Melvin-Larsson/keyboard/keyboard/keyboard.csv

Reference | Qty | Value | DNP | Exclude from BOM | Exclude from Board | Footprint | Datasheet
3.3V1,BAT+1,BAT-1,CAPS2,CHG1,CHOUT1,DIS1,FUELOUT1,GND1,NUM2,RCLK1,REG1,SCROLL2,SER1,SRCLK1,STAT1,STAT2,USB_on1,VBUS1 | 19 | TestPoint |  |  |  | TestPoint:TestPoint_THTPad_D2.0mm_Drill1.0mm
AE1 | 1 | Antenna_Chip |  |  |  | footprints:PCB-Antenna
BT1 | 1 | Battery_Cell |  |  |  | footprints:solder_pads
C1,C15,C18,C19,C20 | 5 | 0.1μF |  |  |  | Capacitor_SMD:C_0603_1608Metric
C2,C3 | 2 | 12pF |  |  |  | Capacitor_SMD:C_0201_0603Metric
C4 | 1 | 0.1uF |  |  |  | Capacitor_SMD:C_0603_1608Metric
C5 | 1 | N.C |  |  |  | Capacitor_SMD:C_0603_1608Metric
C7,C27,C28 | 3 | 4.7μF |  |  |  | Capacitor_SMD:C_0201_0603Metric
C11,C12 | 2 | 10μf |  |  |  | Capacitor_SMD:C_0603_1608Metric
C13 | 1 | 1μf |  |  |  | Capacitor_SMD:C_0603_1608Metric
C14,C16,C17 | 3 | 10μF |  |  |  | Capacitor_SMD:C_0603_1608Metric
C21 | 1 | 0.47μF |  |  |  | Capacitor_SMD:C_0603_1608Metric
C25,C29 | 2 | 1.0μF |  |  |  | Capacitor_SMD:C_0201_0603Metric
C26 | 1 | 4.7uF |  |  |  | Capacitor_SMD:C_0201_0603Metric
C30,C35 | 2 | 100nF |  |  |  | Capacitor_SMD:C_0201_0603Metric
C31 | 1 | 100pF |  |  |  | Capacitor_SMD:C_0201_0603Metric
C32 | 1 | N.C. |  |  |  | Capacitor_SMD:C_0201_0603Metric
C33 | 1 | 1.0pF |  |  |  | Capacitor_SMD:C_0201_0603Metric
C34 | 1 | 1.2pF |  |  |  | Capacitor_SMD:C_0201_0603Metric
CAPS1,D82,D83,D84,NUM1,Scroll1 | 6 | LED |  |  |  | LED_SMD:LED_0603_1608Metric
D1,D2,D3,D4,D5,D6,D7,D8,D9,D10,D11,D12,D13,D14,D15,D16,D17,D18,D19,D20,D21,D22,D23,D24,D25,D26,D27,D28,D29,D30,D31,D32,D33,D34,D35,D36,D37,D38,D39,D40,D41,D42,D44,D45,D46,D47,D48,D49,D50,D51,D52,D53,D54,D55,D56,D57,D58,D59,D60,D61,D62,D63,D64,D65,D66,D67,D68,D69,D70 | 69 | D_Small |  |  |  | Diode_SMD:D_SOD-323
D85 | 1 | D_TVS |  |  |  | Diode_SMD:Nexperia_DSN1608-2_1.6x0.8mm
J1 | 1 | Conn_01x06_Pin |  |  |  | Connector_PinHeader_2.54mm:PinHeader_2x03_P2.54mm_Vertical
L1 | 1 | 4.7nH |  |  |  | Inductor_SMD:L_0201_0603Metric
L2 | 1 | 2.2μH |  |  |  | Inductor_SMD:L_6.3x6.3_H3
L3 | 1 | 2.2nH |  |  |  | Inductor_SMD:L_0201_0603Metric
P1 | 1 | USB_C_Plug_USB2.0 |  |  |  | Connector_USB:USB_C_Receptacle_G-Switch_GT-USB-7010ASV | https://www.usb.org/sites/default/files/documents/usb_type-c.zip
Q1,Q2,Q3,Q4,Q5 | 5 | Q_NMOS_GSD |  |  |  | Package_TO_SOT_SMD:SOT-23
R1,R2,R3,R13 | 4 | 100kΩ |  |  |  | Resistor_SMD:R_0603_1608Metric
R4,R5 | 2 | 5.1kΩ |  |  |  | Resistor_SMD:R_0603_1608Metric
R10,R11,R12 | 3 | 330Ω |  |  |  | Resistor_SMD:R_0603_1608Metric
R14 | 1 | 37.4kΩ |  |  |  | Resistor_SMD:R_0603_1608Metric
R15,R17,R19 | 3 | R_Small |  |  |  | Resistor_SMD:R_0603_1608Metric
R16,R18,R21 | 3 | 10kΩ |  |  |  | Resistor_SMD:R_0603_1608Metric
R20 | 1 | 10kΩ |  |  |  | Resistor_SMD:R_0201_0603Metric
R22 | 1 | 1070Ω |  |  |  | Resistor_SMD:R_0603_1608Metric
R23,R26 | 2 | 100Ω |  |  |  | Resistor_SMD:R_0603_1608Metric
R24,R27 | 2 | 1kΩ |  |  |  | Resistor_SMD:R_0603_1608Metric
R25 | 1 | 10mΩ |  |  |  | Resistor_SMD:R_0603_1608Metric
R28 | 1 | 4.7kΩ |  |  |  | Resistor_SMD:R_0603_1608Metric
SW1 | 1 | SW_SPST |  |  |  | footprints:21-0137I_T1433-2_MXM
SW1_1,SW1_2,SW1_3,SW1_4,SW1_5,SW1_6,SW1_7,SW1_8,SW1_9,SW1_10,SW1_11,SW1_12,SW1_13,SW1_15,SW2_2,SW2_3,SW2_4,SW2_5,SW2_6,SW2_7,SW2_8,SW2_9,SW2_10,SW2_11,SW2_12,SW2_13,SW2_15,SW3_2,SW3_3,SW3_4,SW3_5,SW3_6,SW3_7,SW3_8,SW3_9,SW3_10,SW3_11,SW3_12,SW3_13,SW3_15,SW4_2,SW4_3,SW4_4,SW4_5,SW4_6,SW4_7,SW4_8,SW4_9,SW4_10,SW4_11,SW4_12,SW4_14,SW4_15,SW5_10,SW5_11,SW5_12,SW5_13,SW5_14,SW5_15 | 59 | CherryMX |  |  |  | Button_Switch_Keyboard:SW_Cherry_MX_1.00u_PCB
SW1_14 | 1 | CherryMX |  |  |  | Button_Switch_Keyboard:SW_Cherry_MX_2.00u_PCB
SW2 | 1 | MFS201N-16-Z |  |  |  | footprints:MFS201N-16-Z_NDC | MFS201N-16-Z
SW2_1 | 1 | CherryMX |  |  |  | Button_Switch_Keyboard:SW_Cherry_MX_1.50u_PCB
SW2_14 | 1 | CherryMX |  |  |  | Button_Switch_Keyboard:SW_Cherry_MX_ISOEnter_PCB
SW3_1,SW4_13 | 2 | CherryMX |  |  |  | Button_Switch_Keyboard:SW_Cherry_MX_1.75u_PCB
SW4_1,SW5_1,SW5_2,SW5_3 | 4 | CherryMX |  |  |  | Button_Switch_Keyboard:SW_Cherry_MX_1.25u_PCB
SW5_7 | 1 | CherryMX |  |  |  | Button_Switch_Keyboard:SW_Cherry_MX_6.25u_PCB
TH1 | 1 | Thermistor |  |  |  | footprints:solder_pads
TH2 | 1 | Thermistor_NTC |  |  |  | footprints:solder_pads
U1,U6 | 2 | SN74HC595PWR |  |  |  | footprints:PW16 | https://www.ti.com/lit/gpn/sn74hc595
U2 | 1 | NRF52833-QDAA-R7 |  |  |  | footprints:QFN40_5X5_DQ_NOR | NRF52833-QDAA-R7
U3 | 1 | BQ24032ARHLR |  |  |  | footprints:RHL0020A | https://www.ti.com/lit/gpn/bq24032a
U4 | 1 | TPS63001 |  |  |  | footprints:TPS63001 | http://www.ti.com/lit/ds/symlink/tps63000.pdf
U5 | 1 | MAX17303G+ |  |  |  | footprints:21-0137I_T1433-2_MXM | MAX17303G+
Y1 | 1 | 32MHz |  |  |  | Crystal:Crystal_SMD_2016-4Pin_2.0x1.6mm
