Melvin-Larsson/keyboard/keyboard/keyboard.ods

Reference | Qty | Value | DNP | Exclude from BOM | Exclude from Board | Footprint | Datasheet | Model | Shop
3.3V1,BAT+1,BAT-1,CAPS2,CHG1,CHOUT1,DIS1,FUELOUT1,GND1,NUM2,RCLK1,REG1,SCROLL2,SER1,SRCLK1,STAT1,STAT2,USB_on1,VBUS1 | 19 | TestPoint |  |  |  | TestPoint:TestPoint_THTPad_D2.0mm_Drill1.0mm |  | NA
AE1 | 1 | Antenna_Chip |  |  |  | footprints:PCB-Antenna |  | NA
BT1 | 1 | Battery_Cell |  |  |  | footprints:solder_pads |  | NA
C1,C15,C18,C19,C20 | 5 | 0.1μF |  |  |  | Capacitor_SMD:C_0603_1608Metric |  | CL10B104KO8NFNC | https://www.digikey.se/en/products/detail/samsung-electro-mechanics/CL10B104KO8NFNC/3887596
C2,C3 | 2 | 12pF |  |  |  | Capacitor_SMD:C_0201_0603Metric |  | GRT0335C1H120FA02D | https://www.digikey.se/en/products/detail/murata-electronics/GRT0335C1H120FA02D/16033374
C4 | 1 | 0.1uF |  |  |  | Capacitor_SMD:C_0603_1608Metric |  | Ordered above CL10B104KO8NFNC
C5 | 1 | N.C |  |  |  | Capacitor_SMD:C_0603_1608Metric |  | NA
C7,C27 | 3 | 4.7μF |  |  |  | Capacitor_SMD:C_0603 |  | KAM15CR70J475KT | https://www.digikey.se/en/products/detail/kyocera-avx/KAM15CR70J475KT/22198412
C11,C12 | 2 | 10μf |  |  |  | Capacitor_SMD:C_0603_1608Metric |  | CL21B106KOQNNNE | https://www.digikey.se/en/products/detail/samsung-electro-mechanics/CL21B106KOQNNNE/3888530
C13 | 1 | 1μf |  |  |  | Capacitor_SMD:C_0603_1608Metric |  | CL10B105KA8NFNC | https://www.digikey.se/en/products/detail/samsung-electro-mechanics/CL10B105KA8NFNC/3887600
C14,C16,C17 | 3 | 10μF |  |  |  | Capacitor_SMD:C_0603_1608Metric |  | Ordered above CL21B106KOQNNNE
C21 | 1 | 0.47μF |  |  |  | Capacitor_SMD:C_0603_1608Metric |  | CL10B474KO8NNND | https://www.digikey.se/en/products/detail/samsung-electro-mechanics/CL10B474KO8NNND/3894317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
C25,C29 | 2 | 1.0μF |  |  |  | Capacitor_SMD:C_0402 |  | GRT155R70J105KE01D | https://www.digikey.se/en/products/detail/murata-electronics/GRT155R70J105KE01D/9867924
C26 | 1 | 4.7uF X7S 10% |  |  |  | Capacitor_SMD:C_603 |  | GRJ188C70J475KE11D | https://www.digikey.se/en/products/detail/murata-electronics/GRJ188C70J475KE11D/5320976
C30,C35, ,C28 | 2 | 100nF |  |  |  | Capacitor_SMD:C_0201_0603Metric |  | GCM033C70J104KE02J | https://www.digikey.se/en/products/detail/murata-electronics/GCM033C70J104KE02J/19115554
C31 | 1 | 100pF |  |  |  | Capacitor_SMD:C_0201_0603Metric |  | GRM0335C1E101JA01D | https://www.digikey.se/en/products/detail/murata-electronics/GRM0335C1E101JA01D/702426
C32 | 1 | N.C. |  |  |  | Capacitor_SMD:C_0201_0603Metric |  | NA
C33 | 1 | 1.0pF |  |  |  | Capacitor_SMD:C_0201_0603Metric |  | GRM0335C1H1R0WA01D | https://www.digikey.se/en/products/detail/murata-electronics/GRM0335C1H1R0WA01D/6606078
C34 | 1 | 1.2pF |  |  |  | Capacitor_SMD:C_0201_0603Metric |  | GRM0335C1H1R2WA01D | https://www.digikey.se/en/products/detail/murata-electronics/GRM0335C1H1R2WA01D/11618559
CAPS1,D82,D83,D84,NUM1,Scroll1 | 6 | LED |  |  |  | LED_SMD:LED_0603_1608Metric |  | APT1608CGCK | https://www.digikey.se/sv/products/detail/kingbright/APT1608CGCK/1747514
D1,D2,D3,D4,D5,D6,D7,D8,D9,D10,D11,D12,D13,D14,D15,D16,D17,D18,D19,D20,D21,D22,D23,D24,D25,D26,D27,D28,D29,D30,D31,D32,D33,D34,D35,D36,D37,D38,D39,D40,D41,D42,D44,D45,D46,D47,D48,D49,D50,D51,D52,D53,D54,D55,D56,D57,D58,D59,D60,D61,D62,D63,D64,D65,D66,D67,D68,D69,D70 | 69 | D_Small |  |  |  | Diode_SMD:D_SOD-323 |  | 1N4448WS | https://www.digikey.se/sv/products/detail/shenzhen-slkormicro-semicon-co-ltd/1N4448WS/26112891
D85 | 1 | D_TVS |  |  |  | Diode_SMD:Nexperia_DSN1608-2_1.6x0.8mm |  | ????????????????
J1 | 1 | Conn_01x06_Pin |  |  |  | Connector_PinHeader_2.54mm:PinHeader_2x03_P2.54mm_Vertical |  | TS-106-T-A | https://www.digikey.se/sv/products/detail/samtec-inc/TS-106-T-A/1105488
L1 | 1 | 4.7nH |  |  |  | Inductor_SMD:L_0201_0603Metric |  | MHQ0603P4N7CT000 | https://www.digikey.se/sv/products/detail/tdk/MHQ0603P4N7CT000/4741941 | Alt. https://www.digikey.se/sv/products/detail/w%C3%BCrth-elektronik/7447820047G/14669557
L2 | 1 | 2.2μH |  |  |  | Inductor_SMD:L_6.3x6.3_H3 |  | ????????????????
L3 | 1 | 2.2nH |  |  |  | Inductor_SMD:L_0201_0603Metric |  | MHQ0603P2N2BTD25 | https://www.digikey.se/sv/products/detail/tdk/MHQ0603P2N2BTD25/8555996
P1 | 1 | USB_C_Plug_USB2.0 |  |  |  | Connector_USB:USB_C_Receptacle_G-Switch_GT-USB-7010ASV | https://www.usb.org/sites/default/files/documents/usb_type-c.zip | LUB-C118D-004-G-19 | https://www.digikey.se/sv/products/detail/linkplex/LUB-C118D-004-G-19/22971448
Q1,Q2,Q3,Q4,Q5 | 5 | Q_NMOS_GSD |  |  |  | Package_TO_SOT_SMD:SOT-23 |  | 03N06L | https://www.digikey.se/sv/products/detail/goford-semiconductor/03N06L/16499561
R1,R2,R3,R13 | 4 | 100kΩ |  |  |  | Resistor_SMD:R_0603_1608Metric |  | CRCW0603100KFKEA | https://www.digikey.se/sv/products/detail/vishay-dale/CRCW0603100KFKEA/1174896
R4,R5 | 2 | 5.1kΩ |  |  |  | Resistor_SMD:R_0603_1608Metric |  | CRCW06035K10FKEA | https://www.digikey.se/sv/products/detail/vishay-dale/CRCW06035K10FKEA/1174748
R10,R11,R12 | 3 | 330Ω |  |  |  | Resistor_SMD:R_0603_1608Metric |  | CRCW0603330RFKEA | https://www.digikey.se/sv/products/detail/vishay-dale/CRCW0603330RFKEA/1174611
R14 | 1 | 37.4kΩ |  |  |  | Resistor_SMD:R_0603_1608Metric |  | CRCW060337K4FKEA | https://www.digikey.se/sv/products/detail/vishay-dale/CRCW060337K4FKEA/1174846
R15,R17,R19 | 3 | R_Small |  |  |  | Resistor_SMD:R_0603_1608Metric |  | ????????????????
R16,R18,R21 | 3 | 10kΩ |  |  |  | Resistor_SMD:R_0603_1608Metric |  | CRCW060310K0FKEA | https://www.digikey.se/sv/products/detail/vishay-dale/CRCW060310K0FKEA/1174782
R20 | 1 | 10kΩ |  |  |  | Resistor_SMD:R_0603_1608Metric |  | Ordered above CRCW060310K0FKEA
R22 | 1 | 1070Ω |  |  |  | Resistor_SMD:R_0603_1608Metric |  | CRCW06031K07FKEA | https://www.digikey.se/sv/products/detail/vishay-dale/CRCW06031K07FKEA/1174671
R23,R26 | 2 | 100Ω |  |  |  | Resistor_SMD:R_0603_1608Metric |  | CRCW0603100RFKEA | https://www.digikey.se/sv/products/detail/vishay-dale/CRCW0603100RFKEA/1174554
R24,R27 | 2 | 1kΩ |  |  |  | Resistor_SMD:R_0603_1608Metric |  | CRCW06031K00FKEA | https://www.digikey.se/sv/products/detail/vishay-dale/CRCW06031K00FKEA/1174668
R25 | 1 | 10mΩ |  |  |  | Resistor_SMD:R_0603_1608Metric |  | ???????????????? SHUNT
R28 | 1 | 4.7kΩ |  |  |  | Resistor_SMD:R_0603_1608Metric |  | CRCW06034K70FKEA | https://www.digikey.se/sv/products/detail/vishay-dale/CRCW06034K70FKEA/1174744
SW1 | 1 | SW_SPST |  |  |  | footprints:21-0137I_T1433-2_MXM |  | ????????????????
SW1_1,SW1_2,SW1_3,SW1_4,SW1_5,SW1_6,SW1_7,SW1_8,SW1_9,SW1_10,SW1_11,SW1_12,SW1_13,SW1_15,SW2_2,SW2_3,SW2_4,SW2_5,SW2_6,SW2_7,SW2_8,SW2_9,SW2_10,SW2_11,SW2_12,SW2_13,SW2_15,SW3_2,SW3_3,SW3_4,SW3_5,SW3_6,SW3_7,SW3_8,SW3_9,SW3_10,SW3_11,SW3_12,SW3_13,SW3_15,SW4_2,SW4_3,SW4_4,SW4_5,SW4_6,SW4_7,SW4_8,SW4_9,SW4_10,SW4_11,SW4_12,SW4_14,SW4_15,SW5_10,SW5_11,SW5_12,SW5_13,SW5_14,SW5_15 | 59 | CherryMX |  |  |  | Button_Switch_Keyboard:SW_Cherry_MX_1.00u_PCB |  | Key switch
SW1_14 | 1 | CherryMX |  |  |  | Button_Switch_Keyboard:SW_Cherry_MX_2.00u_PCB |  | Key switch
SW2 | 1 | MFS201N-16-Z |  |  |  | footprints:MFS201N-16-Z_NDC | MFS201N-16-Z | MFS201N-16-Z | https://www.digikey.se/en/products/detail/nidec-components/MFS201N-16-Z/5086548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
SW2_1 | 1 | CherryMX |  |  |  | Button_Switch_Keyboard:SW_Cherry_MX_1.50u_PCB |  | Key switch
SW2_14 | 1 | CherryMX |  |  |  | Button_Switch_Keyboard:SW_Cherry_MX_ISOEnter_PCB |  | Key switch
SW3_1,SW4_13 | 2 | CherryMX |  |  |  | Button_Switch_Keyboard:SW_Cherry_MX_1.75u_PCB |  | Key switch
SW4_1,SW5_1,SW5_2,SW5_3 | 4 | CherryMX |  |  |  | Button_Switch_Keyboard:SW_Cherry_MX_1.25u_PCB |  | Key switch
SW5_7 | 1 | CherryMX |  |  |  | Button_Switch_Keyboard:SW_Cherry_MX_6.25u_PCB |  | Key switch
TH1 | 1 | Thermistor |  |  |  | footprints:solder_pads |  | NA
TH2 | 1 | Thermistor_NTC |  |  |  | footprints:solder_pads |  | NA
U1,U6 | 2 | SN74HC595PWR |  |  |  | footprints:PW16 | https://www.ti.com/lit/gpn/sn74hc595 | SN74HC595PWR | https://www.digikey.se/en/products/detail/texas-instruments/SN74HC595PWR/1571275
U2 | 1 | NRF52833-QDAA-R7 |  |  |  | footprints:QFN40_5X5_DQ_NOR | NRF52833-QDAA-R7 | NRF52833-QDAA-B-R | https://www.digikey.se/en/products/detail/nordic-semiconductor-asa/NRF52833-QDAA-B-R/15998596
U3 | 1 | BQ24032ARHLR |  |  |  | footprints:RHL0020A | https://www.ti.com/lit/gpn/bq24032a | BQ24032ARHLR | https://www.digikey.se/en/products/detail/texas-instruments/BQ24032ARHLR/807592
U4 | 1 | TPS63001 |  |  |  | footprints:TPS63001 | http://www.ti.com/lit/ds/symlink/tps63000.pdf | TPS63001DRCR | https://www.digikey.se/en/products/detail/texas-instruments/TPS63001DRCR/1016476
U5 | 1 | MAX17303G+ |  |  |  | footprints:21-0137I_T1433-2_MXM | MAX17303G+ | MAX17303G+ | https://www.digikey.se/en/products/detail/analog-devices-inc-maxim-integrated/MAX17303G/17885206
Y1 | 1 | 32MHz |  |  |  | Crystal:Crystal_SMD_2016-4Pin_2.0x1.6mm |  | ECS-320-8-37B-CKY-TR | https://www.digikey.se/sv/products/detail/ecs-inc/ECS-320-8-37B-CKY-TR/9838854
Male connector SYR-02TV | 1 |  |  |  |  |  |  | https://www.digikey.com/en/products/detail/jst-sales-america-inc/SYR-02TV/2385865
Crimp thingy: SYM-001T-P0.6 | 1 |  |  |  |  |  |  | https://www.electrokit.com/en/crimpstift-rcy-awg28-22
Thermistors
