Melvin-Larsson/keyboard/case.FCStd

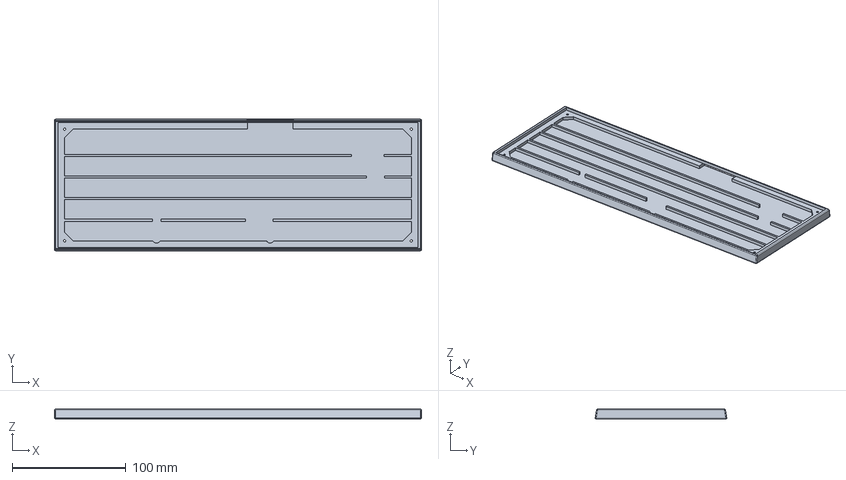
[picture p1: CAD file, 2026-11-01]
case.FCStd
322.8 x 115.7 x 9.00 mm
