Melvin-Larsson/keyboard/model.step

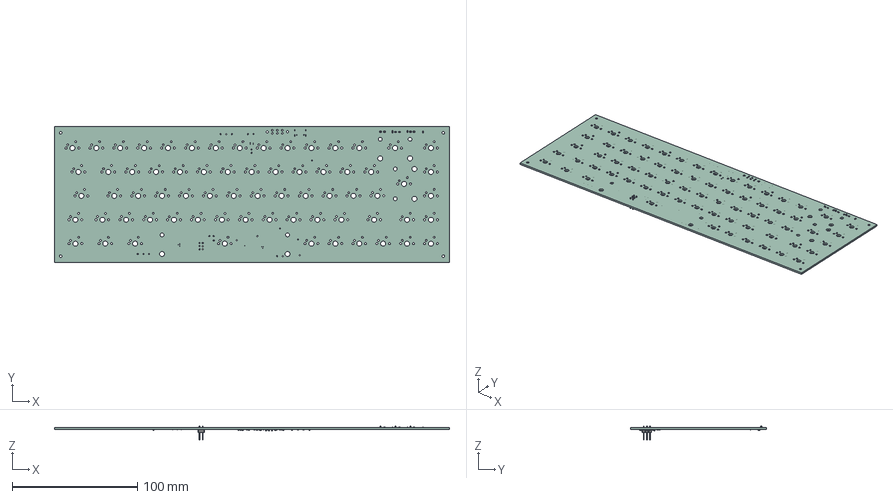
[picture p2: CAD file, 2026-11-01]
model.step
314.8 x 108.1 x 11.5 mm
R_0603_1608Metric x 23
LED_0603_1608Metric x 6
C_0603_1608Metric x 14
C_0201_0603Metric x 3
PinHeader_2x03_P254mm_Vertical
keyboard_PCB
