Melvin-Larsson/keyboard/keyboard/keyboard.kicad_pcb

## KiCad design keyboard/keyboard.kicad_pcb (2026-11-02)

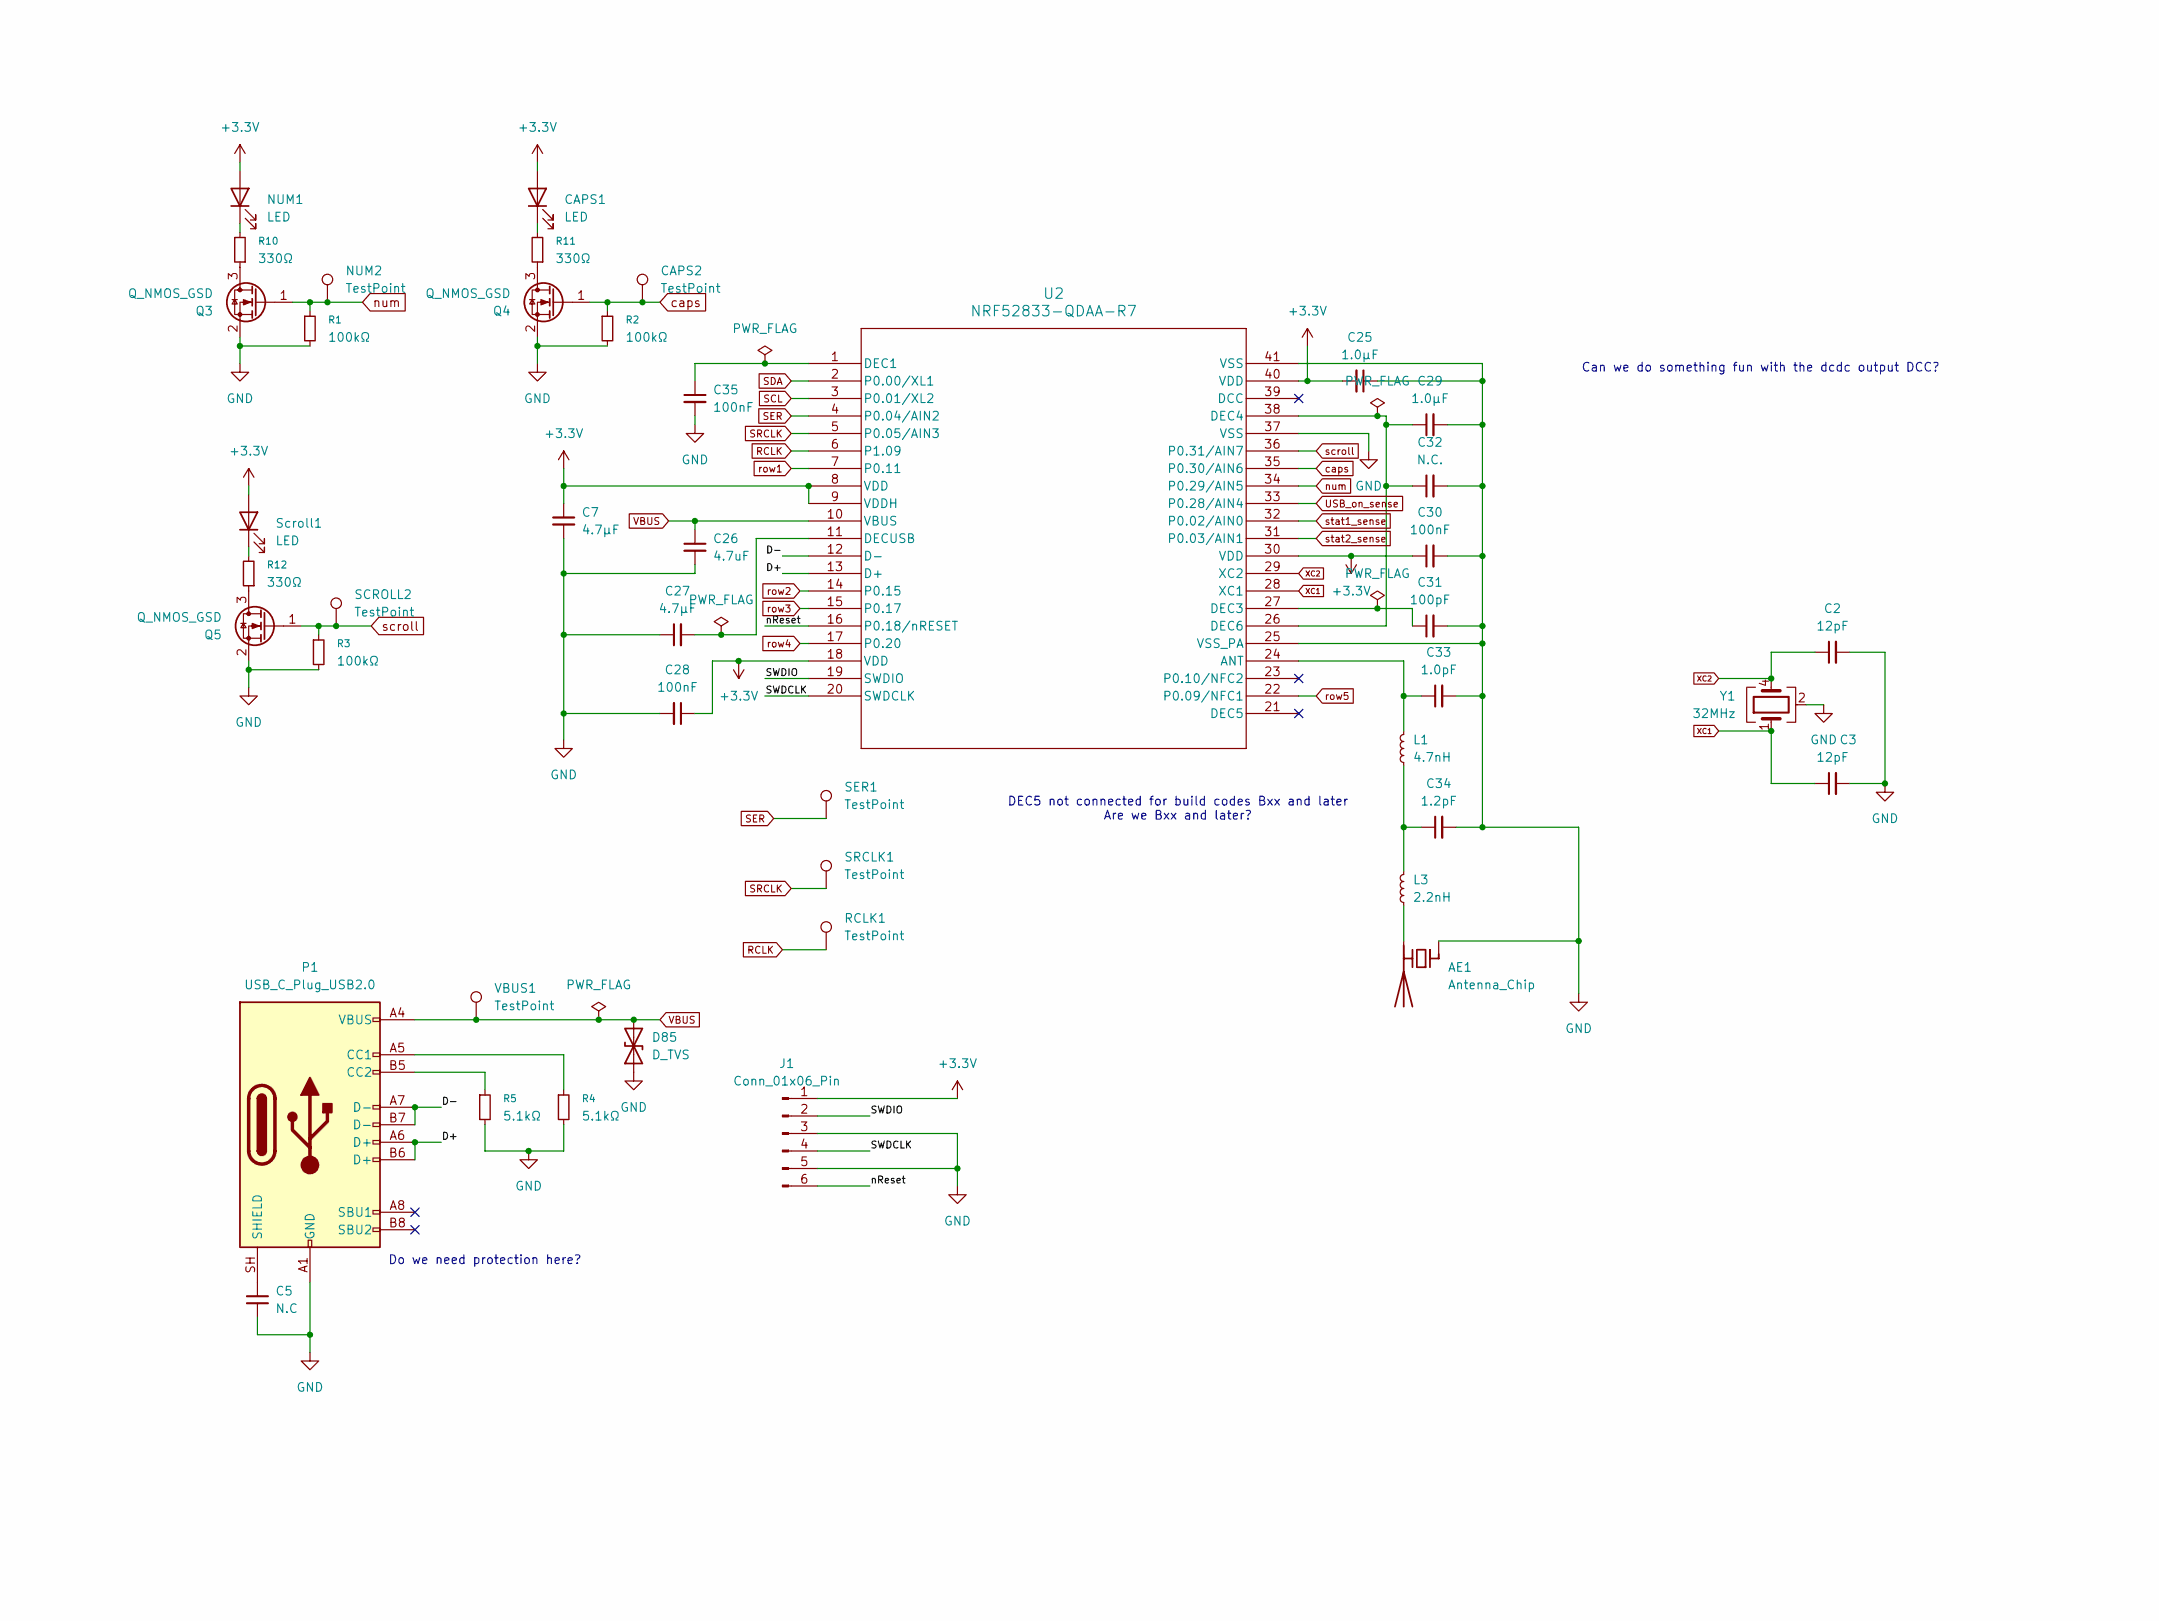
[picture p3: schematic keyboard.kicad_sch, part in row 1, column 1]

Parts:
AE1: Antenna_Chip; PCB-Antenna
C2, C3: 12pF; C_0201_0603Metric
C5: N.C; C_0603_1608Metric
C7, C27: 4.7μF; C_0603_1608Metric
C25, C29: 1.0μF; C_0402_1005Metric
C26: 4.7uF; C_0603_1608Metric
C28, C30, C35: 100nF; C_0201_0603Metric
C31: 100pF; C_0201_0603Metric
C32: N.C.; C_0201_0603Metric
C33: 1.0pF; C_0201_0603Metric
C34: 1.2pF; C_0201_0603Metric
CAPS1: LED; LED_0603_1608Metric
CAPS2: TestPoint; TestPoint_THTPad_D2.0mm_Drill1.0mm
D85: D_TVS; Nexperia_DSN1608-2_1.6x0.8mm
J1: Conn_01x06_Pin; PinHeader_2x03_P2.54mm_Vertical
L1: 4.7nH; L_0201_0603Metric
L3: 2.2nH; L_0201_0603Metric
NUM1: LED; LED_0603_1608Metric
NUM2: TestPoint; TestPoint_THTPad_D2.0mm_Drill1.0mm
P1: USB_C_Plug_USB2.0; USB_C_Receptacle_G-Switch_GT-USB-7010ASV
Q3, Q4, Q5: Q_NMOS_GSD; SOT-23
R1, R2, R3: 100kΩ; R_0603_1608Metric
R4, R5: 5.1kΩ; R_0603_1608Metric
R10, R11, R12: 330Ω; R_0603_1608Metric
RCLK1: TestPoint; TestPoint_THTPad_D2.0mm_Drill1.0mm
SCROLL2: TestPoint; TestPoint_THTPad_D2.0mm_Drill1.0mm
SER1: TestPoint; TestPoint_THTPad_D2.0mm_Drill1.0mm
SRCLK1: TestPoint; TestPoint_THTPad_D2.0mm_Drill1.0mm
Scroll1: LED; LED_0603_1608Metric
U2: NRF52833-QDAA-R7; QFN40_5X5_DQ_NOR
VBUS1: TestPoint; TestPoint_THTPad_D2.0mm_Drill1.0mm
Y1: 32MHz; Crystal_SMD_2016-4Pin_2.0x1.6mm

Connections:
+3.3V: C7.1, C25.2, C28.1, C30.1, CAPS1.2 (A), J1.1, NUM1.2 (A), Scroll1.2 (A), U2.8 (VDD), U2.9 (VDDH), U2.18 (VDD), U2.30 (VDD), U2.40 (VDD); also elsewhere on the board
/D+: P1.A6 (D+), P1.B6 (D+), U2.13 (D+)
/D-: P1.A7 (D-), P1.B7 (D-), U2.12 (D-)
/SWDCLK: J1.4, U2.20 (SWDCLK)
/SWDIO: J1.2, U2.19 (SWDIO)
/nReset: J1.6, U2.16 (P0.18/nRESET)
GND: AE1.1 (FEED), C2.2, C3.2, C5.2, C7.2, C25.1, C26.2, C27.1, C28.2, C29.2, C30.2, C31.2, C32.2, C33.2, C34.2, C35.2, D85.1 (A1), J1.3, J1.5, P1.A1 (GND), P1.A12 (GND), P1.B1 (GND), P1.B12 (GND), Q3.2 (S), Q4.2 (S), Q5.2 (S), R1.2, R2.2, R3.2, R4.2, R5.2, U2.25 (VSS_PA), U2.37 (VSS), U2.41 (VSS), Y1.2 (G), Y1.3 (G); also elsewhere on the board
unnamed: AE1.2 (PCB_Trace), L3.1
unnamed: C34.1, L1.1, L3.2
unnamed: CAPS1.1 (K), R11.2
unnamed: NUM1.1 (K), R10.2
unnamed: P1.A5 (CC1), R4.1
unnamed: P1.B5 (CC2), R5.1
unnamed: C5.1, P1.SH (SHIELD)
unnamed: Q3.3 (D), R10.1
unnamed: Q4.3 (D), R11.1
unnamed: Q5.3 (D), R12.1
unnamed: R12.2, Scroll1.1 (K)
unnamed: C33.1, L1.2, U2.24 (ANT)
unnamed: C35.1, U2.1 (DEC1)
unnamed: C31.1, U2.27 (DEC3)
unnamed: C29.1, C32.1, U2.26 (DEC6), U2.38 (DEC4)
unnamed: C27.2, U2.11 (DECUSB)
RCLK: RCLK1.1 (1_1), U2.6 (P1.09); also elsewhere on the board
SCL: U2.3 (P0.01/XL2); also elsewhere on the board
SDA: U2.2 (P0.00/XL1); also elsewhere on the board
SER: SER1.1 (1_1), U2.4 (P0.04/AIN2); also elsewhere on the board
SRCLK: SRCLK1.1 (1_1), U2.5 (P0.05/AIN3); also elsewhere on the board
STAT1: U2.32 (P0.02/AIN0); also elsewhere on the board
STAT2: U2.31 (P0.03/AIN1); also elsewhere on the board
USBPG_N: U2.33 (P0.28/AIN4); also elsewhere on the board
VBUS: C26.1, D85.2 (A2), P1.A4 (VBUS), P1.A9 (VBUS), P1.B4 (VBUS), P1.B9 (VBUS), U2.10 (VBUS), VBUS1.1 (1_1); also elsewhere on the board
XC1: C3.1, U2.28 (XC1), Y1.1
XC2: C2.1, U2.29 (XC2), Y1.4
caps: CAPS2.1 (1_1), Q4.1 (G), R2.1, U2.35 (P0.30/AIN6)
num: NUM2.1 (1_1), Q3.1 (G), R1.1, U2.34 (P0.29/AIN5)
row1: U2.7 (P0.11); also elsewhere on the board
row2: U2.14 (P0.15); also elsewhere on the board
row3: U2.15 (P0.17); also elsewhere on the board
row4: U2.17 (P0.20); also elsewhere on the board
row5: U2.22 (P0.09/NFC1); also elsewhere on the board
scroll: Q5.1 (G), R3.1, SCROLL2.1 (1_1), U2.36 (P0.31/AIN7)

Notes on the sheet:
Do we need protection here?
DEC5 not connected for build codes Bxx and later Are we Bxx and later?
Can we do something fun with the dcdc output DCC?

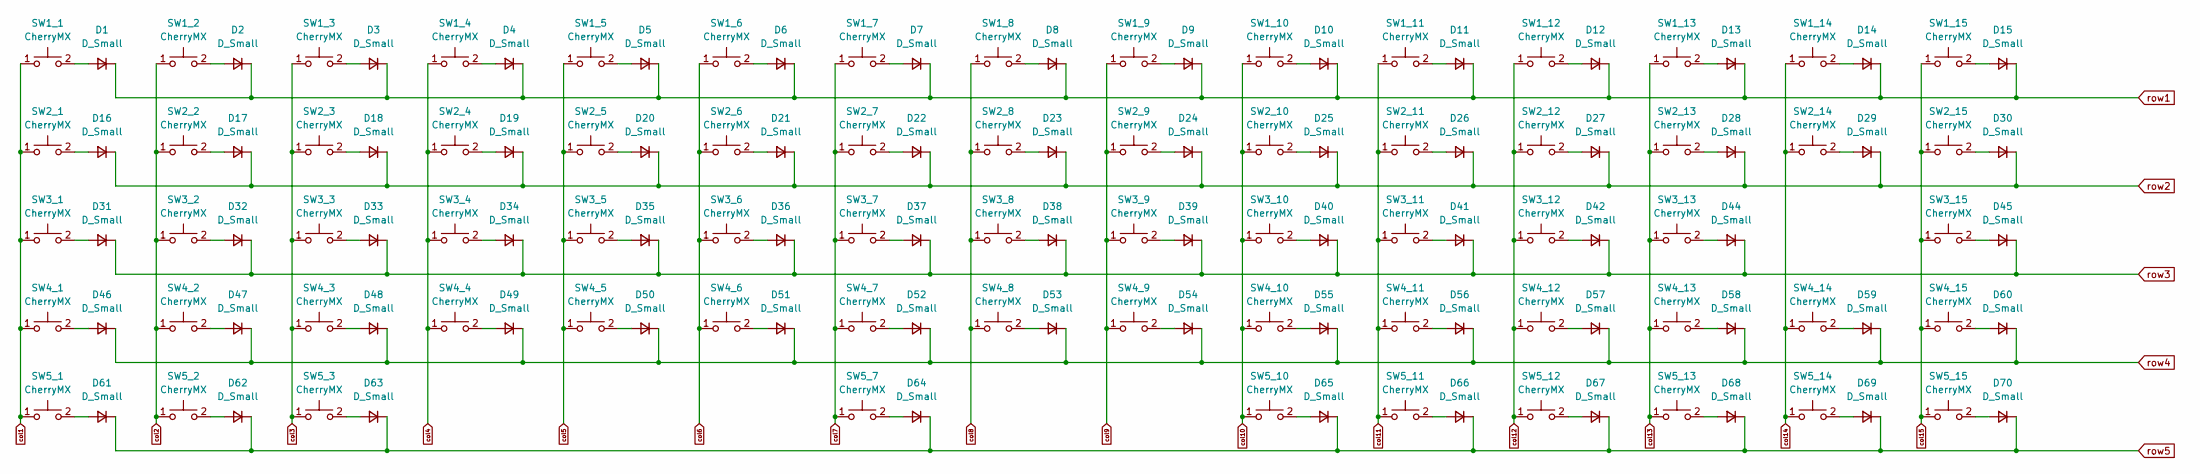
[picture p4: schematic untitled.kicad_sch]

Parts:
D1, D2, D3, D4, D5, D6, D7, D8, D9, D10, D11, D12, D13, D14, D15, D16, D17, D18, D19, D20, D21, D22, D23, D24, D25, D26, D27, D28, D29, D30, D31, D32, D33, D34, D35, D36, D37, D38, D39, D40, D41, D42, D44, D45, D46, D47, D48, D49, D50, D51, D52, D53, D54, D55, D56, D57, D58, D59, D60, D61, D62, D63, D64, D65, D66, D67, D68, D69, D70: D_Small; D_SOD-323
SW1_1, SW1_2, SW1_3, SW1_4, SW1_5, SW1_6, SW1_7, SW1_8, SW1_9, SW1_10, SW1_11, SW1_12, SW1_13, SW1_15, SW2_2, SW2_3, SW2_4, SW2_5, SW2_6, SW2_7, SW2_8, SW2_9, SW2_10, SW2_11, SW2_12, SW2_13, SW2_15, SW3_2, SW3_3, SW3_4, SW3_5, SW3_6, SW3_7, SW3_8, SW3_9, SW3_10, SW3_11, SW3_12, SW3_13, SW3_15, SW4_2, SW4_3, SW4_4, SW4_5, SW4_6, SW4_7, SW4_8, SW4_9, SW4_10, SW4_11, SW4_12, SW4_14, SW4_15, SW5_10, SW5_11, SW5_12, SW5_13, SW5_14, SW5_15: CherryMX; SW_Cherry_MX_1.00u_PCB
SW1_14: CherryMX; SW_Cherry_MX_2.00u_PCB
SW2_1: CherryMX; SW_Cherry_MX_1.50u_PCB
SW2_14: CherryMX; SW_Cherry_MX_ISOEnter_PCB
SW3_1, SW4_13: CherryMX; SW_Cherry_MX_1.75u_PCB
SW4_1, SW5_1, SW5_2, SW5_3: CherryMX; SW_Cherry_MX_1.25u_PCB
SW5_7: CherryMX; SW_Cherry_MX_6.25u_PCB

Connections:
unnamed: D1.2 (A), SW1_1.2
unnamed: D2.2 (A), SW1_2.2
unnamed: D3.2 (A), SW1_3.2
unnamed: D4.2 (A), SW1_4.2
unnamed: D5.2 (A), SW1_5.2
unnamed: D6.2 (A), SW1_6.2
unnamed: D7.2 (A), SW1_7.2
unnamed: D8.2 (A), SW1_8.2
unnamed: D9.2 (A), SW1_9.2
unnamed: D10.2 (A), SW1_10.2
unnamed: D11.2 (A), SW1_11.2
unnamed: D12.2 (A), SW1_12.2
unnamed: D13.2 (A), SW1_13.2
unnamed: D14.2 (A), SW1_14.2
unnamed: D15.2 (A), SW1_15.2
unnamed: D16.2 (A), SW2_1.2
unnamed: D17.2 (A), SW2_2.2
unnamed: D18.2 (A), SW2_3.2
unnamed: D19.2 (A), SW2_4.2
unnamed: D20.2 (A), SW2_5.2
unnamed: D21.2 (A), SW2_6.2
unnamed: D22.2 (A), SW2_7.2
unnamed: D23.2 (A), SW2_8.2
unnamed: D24.2 (A), SW2_9.2
unnamed: D25.2 (A), SW2_10.2
unnamed: D26.2 (A), SW2_11.2
unnamed: D27.2 (A), SW2_12.2
unnamed: D28.2 (A), SW2_13.2
unnamed: D29.2 (A), SW2_14.2
unnamed: D30.2 (A), SW2_15.2
unnamed: D31.2 (A), SW3_1.2
unnamed: D32.2 (A), SW3_2.2
unnamed: D33.2 (A), SW3_3.2
unnamed: D34.2 (A), SW3_4.2
unnamed: D35.2 (A), SW3_5.2
unnamed: D36.2 (A), SW3_6.2
unnamed: D37.2 (A), SW3_7.2
unnamed: D38.2 (A), SW3_8.2
unnamed: D39.2 (A), SW3_9.2
unnamed: D40.2 (A), SW3_10.2
unnamed: D41.2 (A), SW3_11.2
unnamed: D42.2 (A), SW3_12.2
unnamed: D44.2 (A), SW3_13.2
unnamed: D45.2 (A), SW3_15.2
unnamed: D46.2 (A), SW4_1.2
unnamed: D47.2 (A), SW4_2.2
unnamed: D48.2 (A), SW4_3.2
unnamed: D49.2 (A), SW4_4.2
unnamed: D50.2 (A), SW4_5.2
unnamed: D51.2 (A), SW4_6.2
unnamed: D52.2 (A), SW4_7.2
unnamed: D53.2 (A), SW4_8.2
unnamed: D54.2 (A), SW4_9.2
unnamed: D55.2 (A), SW4_10.2
unnamed: D56.2 (A), SW4_11.2
unnamed: D57.2 (A), SW4_12.2
unnamed: D58.2 (A), SW4_13.2
unnamed: D59.2 (A), SW4_14.2
unnamed: D60.2 (A), SW4_15.2
unnamed: D61.2 (A), SW5_1.2
unnamed: D62.2 (A), SW5_2.2
unnamed: D63.2 (A), SW5_3.2
unnamed: D64.2 (A), SW5_7.2
unnamed: D65.2 (A), SW5_10.2
unnamed: D66.2 (A), SW5_11.2
unnamed: D67.2 (A), SW5_12.2
unnamed: D68.2 (A), SW5_13.2
unnamed: D69.2 (A), SW5_14.2
unnamed: D70.2 (A), SW5_15.2
col1: SW1_1.1, SW2_1.1, SW3_1.1, SW4_1.1, SW5_1.1; also elsewhere on the board
col2: SW1_2.1, SW2_2.1, SW3_2.1, SW4_2.1, SW5_2.1; also elsewhere on the board
col3: SW1_3.1, SW2_3.1, SW3_3.1, SW4_3.1, SW5_3.1; also elsewhere on the board
col4: SW1_4.1, SW2_4.1, SW3_4.1, SW4_4.1; also elsewhere on the board
col5: SW1_5.1, SW2_5.1, SW3_5.1, SW4_5.1; also elsewhere on the board
col6: SW1_6.1, SW2_6.1, SW3_6.1, SW4_6.1; also elsewhere on the board
col7: SW1_7.1, SW2_7.1, SW3_7.1, SW4_7.1, SW5_7.1; also elsewhere on the board
col8: SW1_8.1, SW2_8.1, SW3_8.1, SW4_8.1; also elsewhere on the board
col9: SW1_9.1, SW2_9.1, SW3_9.1, SW4_9.1; also elsewhere on the board
col10: SW1_10.1, SW2_10.1, SW3_10.1, SW4_10.1, SW5_10.1; also elsewhere on the board
col11: SW1_11.1, SW2_11.1, SW3_11.1, SW4_11.1, SW5_11.1; also elsewhere on the board
col12: SW1_12.1, SW2_12.1, SW3_12.1, SW4_12.1, SW5_12.1; also elsewhere on the board
col13: SW1_13.1, SW2_13.1, SW3_13.1, SW4_13.1, SW5_13.1; also elsewhere on the board
col14: SW1_14.1, SW2_14.1, SW4_14.1, SW5_14.1; also elsewhere on the board
col15: SW1_15.1, SW2_15.1, SW3_15.1, SW4_15.1, SW5_15.1; also elsewhere on the board
row1: D1.1 (K), D2.1 (K), D3.1 (K), D4.1 (K), D5.1 (K), D6.1 (K), D7.1 (K), D8.1 (K), D9.1 (K), D10.1 (K), D11.1 (K), D12.1 (K), D13.1 (K), D14.1 (K), D15.1 (K); also elsewhere on the board
row2: D16.1 (K), D17.1 (K), D18.1 (K), D19.1 (K), D20.1 (K), D21.1 (K), D22.1 (K), D23.1 (K), D24.1 (K), D25.1 (K), D26.1 (K), D27.1 (K), D28.1 (K), D29.1 (K), D30.1 (K); also elsewhere on the board
row3: D31.1 (K), D32.1 (K), D33.1 (K), D34.1 (K), D35.1 (K), D36.1 (K), D37.1 (K), D38.1 (K), D39.1 (K), D40.1 (K), D41.1 (K), D42.1 (K), D44.1 (K), D45.1 (K); also elsewhere on the board
row4: D46.1 (K), D47.1 (K), D48.1 (K), D49.1 (K), D50.1 (K), D51.1 (K), D52.1 (K), D53.1 (K), D54.1 (K), D55.1 (K), D56.1 (K), D57.1 (K), D58.1 (K), D59.1 (K), D60.1 (K); also elsewhere on the board
row5: D61.1 (K), D62.1 (K), D63.1 (K), D64.1 (K), D65.1 (K), D66.1 (K), D67.1 (K), D68.1 (K), D69.1 (K), D70.1 (K); also elsewhere on the board

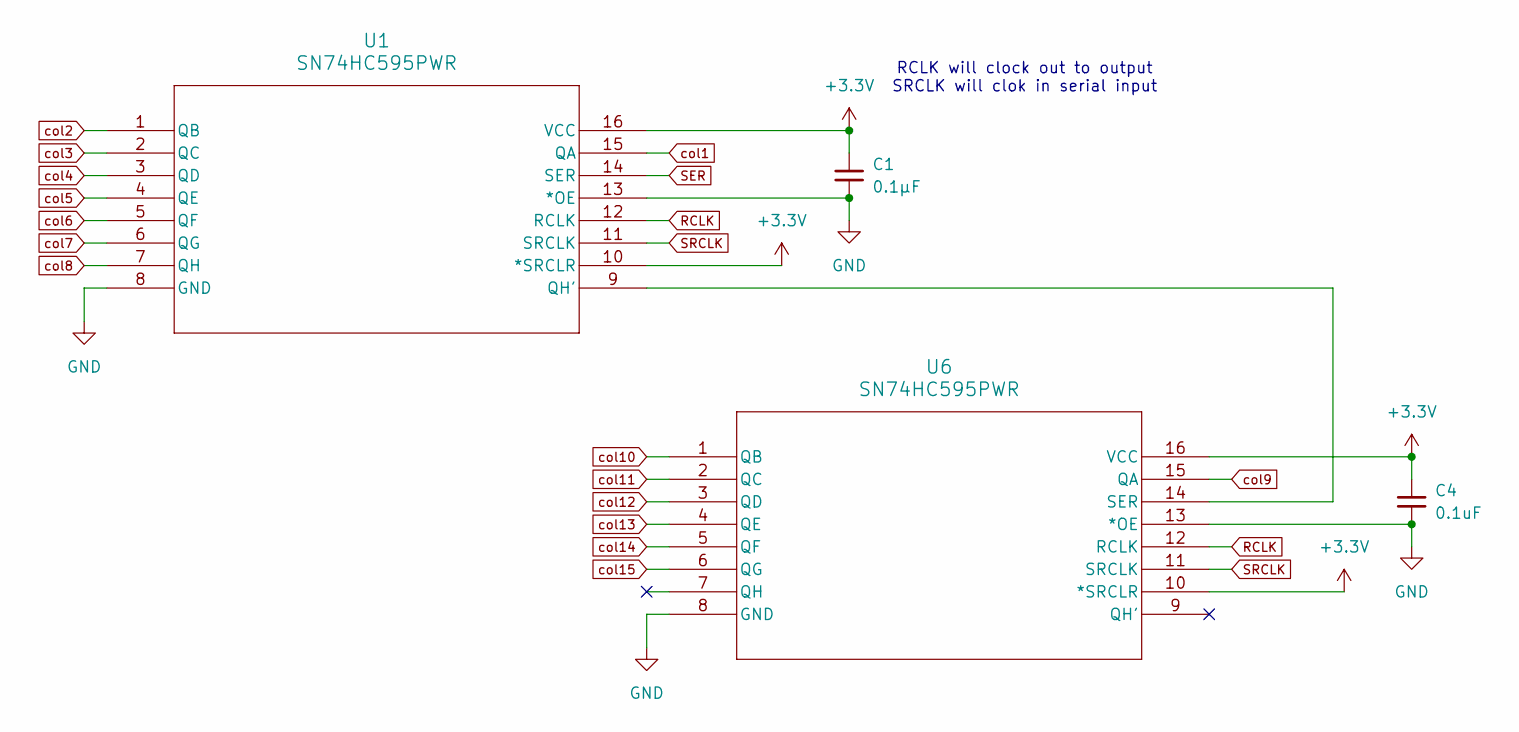
[picture p5: schematic shift_register.kicad_sch]

Parts:
C1: 0.1μF; C_0603_1608Metric
C4: 0.1uF; C_0603_1608Metric
U1, U6: SN74HC595PWR; PW16

Connections:
+3.3V: C1.1, C4.1, U1.10 (*SRCLR), U1.16 (VCC), U6.10 (*SRCLR), U6.16 (VCC); also elsewhere on the board
GND: C1.2, C4.2, U1.8 (GND), U1.13 (*OE), U6.8 (GND), U6.13 (*OE); also elsewhere on the board
unnamed: U1.9 (QH'), U6.14 (SER)
RCLK: U1.12 (RCLK), U6.12 (RCLK); also elsewhere on the board
SER: U1.14 (SER); also elsewhere on the board
SRCLK: U1.11 (SRCLK), U6.11 (SRCLK); also elsewhere on the board
col1: U1.15 (QA); also elsewhere on the board
col2: U1.1 (QB); also elsewhere on the board
col3: U1.2 (QC); also elsewhere on the board
col4: U1.3 (QD); also elsewhere on the board
col5: U1.4 (QE); also elsewhere on the board
col6: U1.5 (QF); also elsewhere on the board
col7: U1.6 (QG); also elsewhere on the board
col8: U1.7 (QH); also elsewhere on the board
col9: U6.15 (QA); also elsewhere on the board
col10: U6.1 (QB); also elsewhere on the board
col11: U6.2 (QC); also elsewhere on the board
col12: U6.3 (QD); also elsewhere on the board
col13: U6.4 (QE); also elsewhere on the board
col14: U6.5 (QF); also elsewhere on the board
col15: U6.6 (QG); also elsewhere on the board

Notes on the sheet:
RCLK will clock out to output SRCLK will clok in serial input

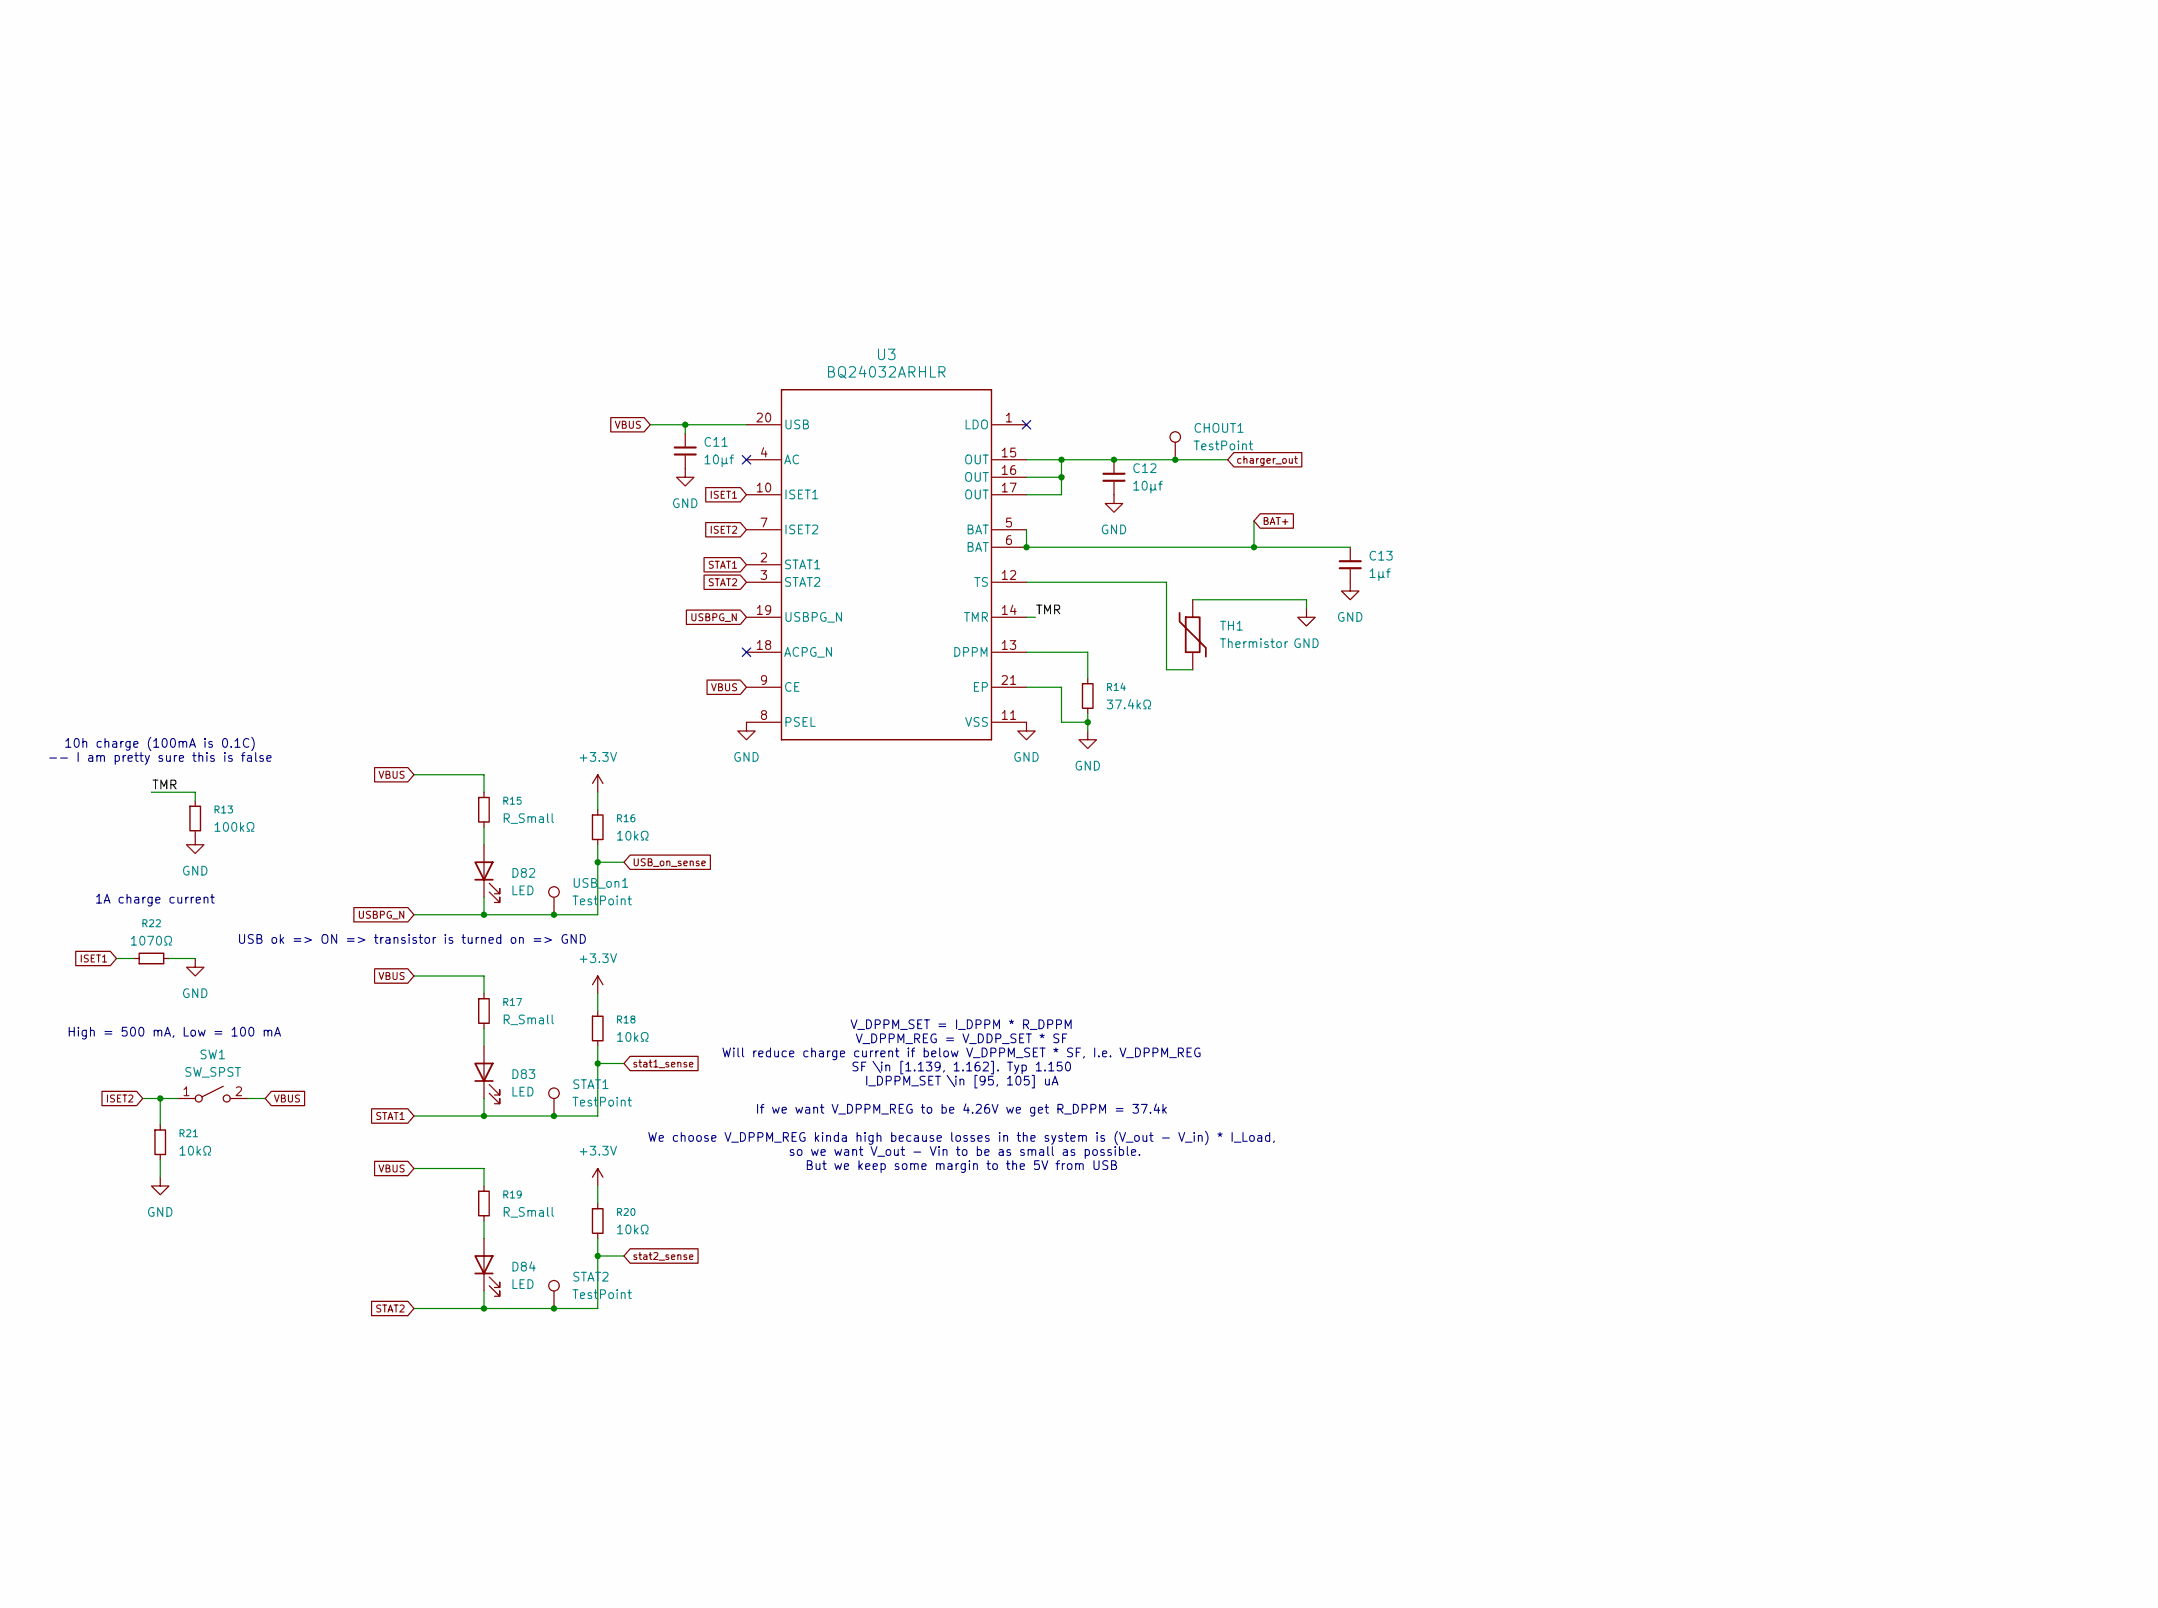
[picture p6: schematic bms.kicad_sch, part in row 1, column 1]

Parts:
C11, C12: 10μf; C_0805_2012Metric
C13: 1μf; C_0603_1608Metric
CHOUT1: TestPoint; TestPoint_THTPad_D2.0mm_Drill1.0mm
D82, D83, D84: LED; LED_0603_1608Metric
R13: 100kΩ; R_0603_1608Metric
R14: 37.4kΩ; R_0603_1608Metric
R15, R17, R19: R_Small; R_0603_1608Metric
R16, R18, R20, R21: 10kΩ; R_0603_1608Metric
R22: 1070Ω; R_0603_1608Metric
STAT1, STAT2: TestPoint; TestPoint_THTPad_D2.0mm_Drill1.0mm
SW1: SW_SPST; 21-0137I_T1433-2_MXM
TH1: Thermistor; solder_pads
U3: BQ24032ARHLR; RHL0020A
USB_on1: TestPoint; TestPoint_THTPad_D2.0mm_Drill1.0mm

Connections:
+3.3V: R16.1, R18.1, R20.1; also elsewhere on the board
/BMS/TMR: R13.1, U3.14 (TMR)
BAT+: C13.1, U3.5 (BAT), U3.6 (BAT); also elsewhere on the board
GND: C11.2, C12.2, C13.2, R13.2, R14.2, R21.2, R22.2, TH1.1, U3.8 (PSEL), U3.11 (VSS), U3.21 (EP); also elsewhere on the board
ISET1: R22.1, U3.10 (ISET1)
ISET2: R21.1, SW1.1 (A), U3.7 (ISET2)
unnamed: D82.2 (A), R15.2
unnamed: D83.2 (A), R17.2
unnamed: D84.2 (A), R19.2
unnamed: R14.1, U3.13 (DPPM)
unnamed: TH1.2, U3.12 (TS)
STAT1: D83.1 (K), R18.2, STAT1.1 (1_1), U3.2 (STAT1); also elsewhere on the board
STAT2: D84.1 (K), R20.2, STAT2.1 (1_1), U3.3 (STAT2); also elsewhere on the board
USBPG_N: D82.1 (K), R16.2, U3.19 (USBPG_N), USB_on1.1 (1_1); also elsewhere on the board
VBUS: C11.1, R15.1, R17.1, R19.1, SW1.2 (B), U3.9 (CE), U3.20 (USB); also elsewhere on the board
charger_out: C12.1, CHOUT1.1 (1_1), U3.15 (OUT), U3.16 (OUT), U3.17 (OUT); also elsewhere on the board

Notes on the sheet:
10h charge (100mA is 0.1C) -- I am pretty sure this is false
USB ok => ON => transistor is turned on => GND
V_DPPM_SET = I_DPPM * R_DPPM V_DPPM_REG = V_DDP_SET * SF Will reduce charge current if below V_DPPM_SET * SF, I.e. V_DPPM_REG SF \in [1.139, 1.162]. Typ 1.150 I_DPPM_SET \in [95, 105] uA If we want V_DPPM_REG to be 4.26V we get R_DPPM = 37.4k We choose V_DPPM_REG kinda high because losses in the sy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
High = 500 mA, Low = 100 mA
1A charge current

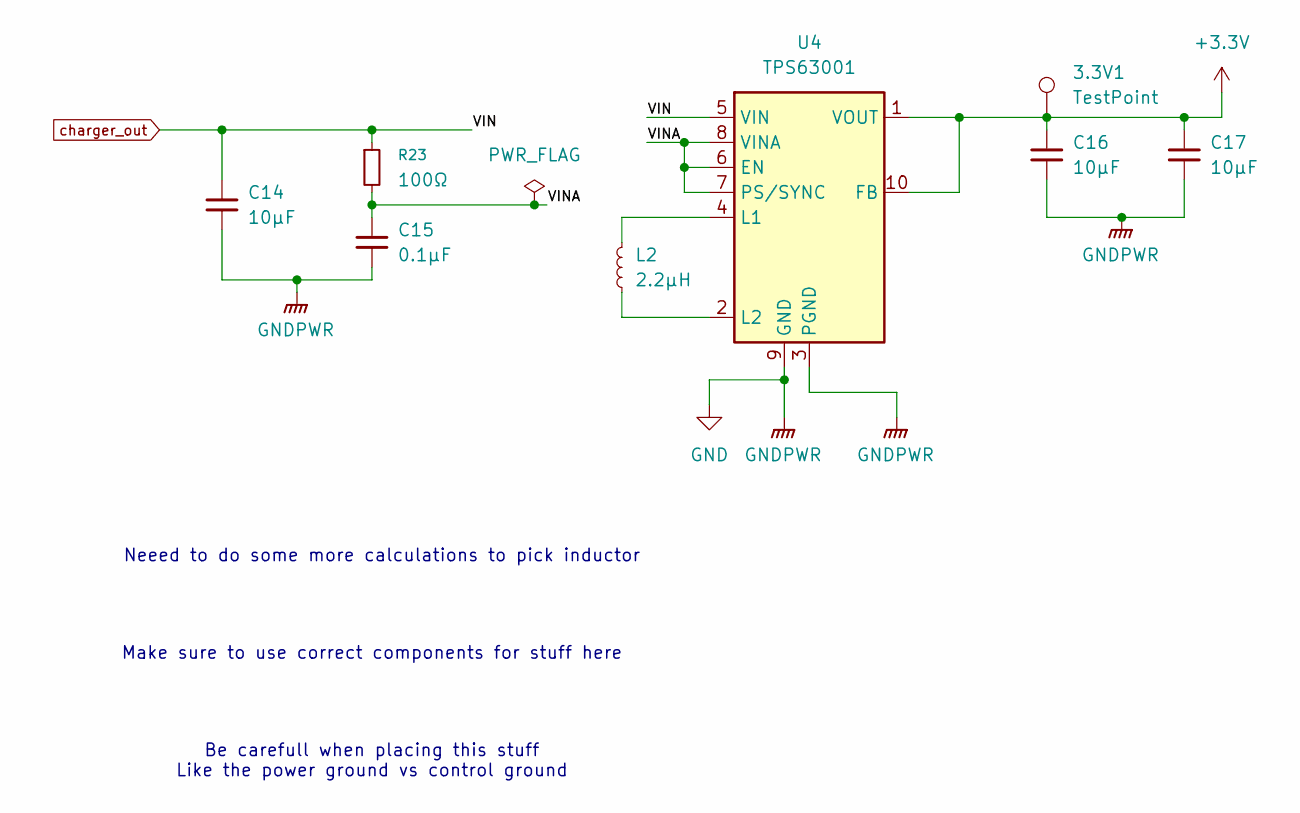
[picture p7: schematic buck_boost.kicad_sch]

Parts:
3.3V1: TestPoint; TestPoint_THTPad_D2.0mm_Drill1.0mm
C14, C16, C17: 10μF; C_0603_1608Metric
C15: 0.1μF; C_0603_1608Metric
L2: 2.2μH; L_6.3x6.3_H3
R23: 100Ω; R_0603_1608Metric
U4: TPS63001

Connections:
+3.3V: 3.3V1.1 (1_1), C16.1, C17.1, U4.1 (VOUT), U4.10 (FB); also elsewhere on the board
/BMS/buck_boost/VINA: C15.1, R23.2, U4.6 (EN), U4.7 (PS/SYNC), U4.8 (VINA)
GND: C14.2, C15.2, C16.2, C17.2, U4.3 (PGND), U4.9 (GND), U4.11 (PGND); also elsewhere on the board
unnamed: L2.2, U4.4 (L1)
unnamed: L2.1, U4.2 (L2)
charger_out: C14.1, R23.1, U4.5 (VIN); also elsewhere on the board

Notes on the sheet:
Neeed to do some more calculations to pick inductor
Make sure to use correct components for stuff here
Be carefull when placing this stuff Like the power ground vs control ground

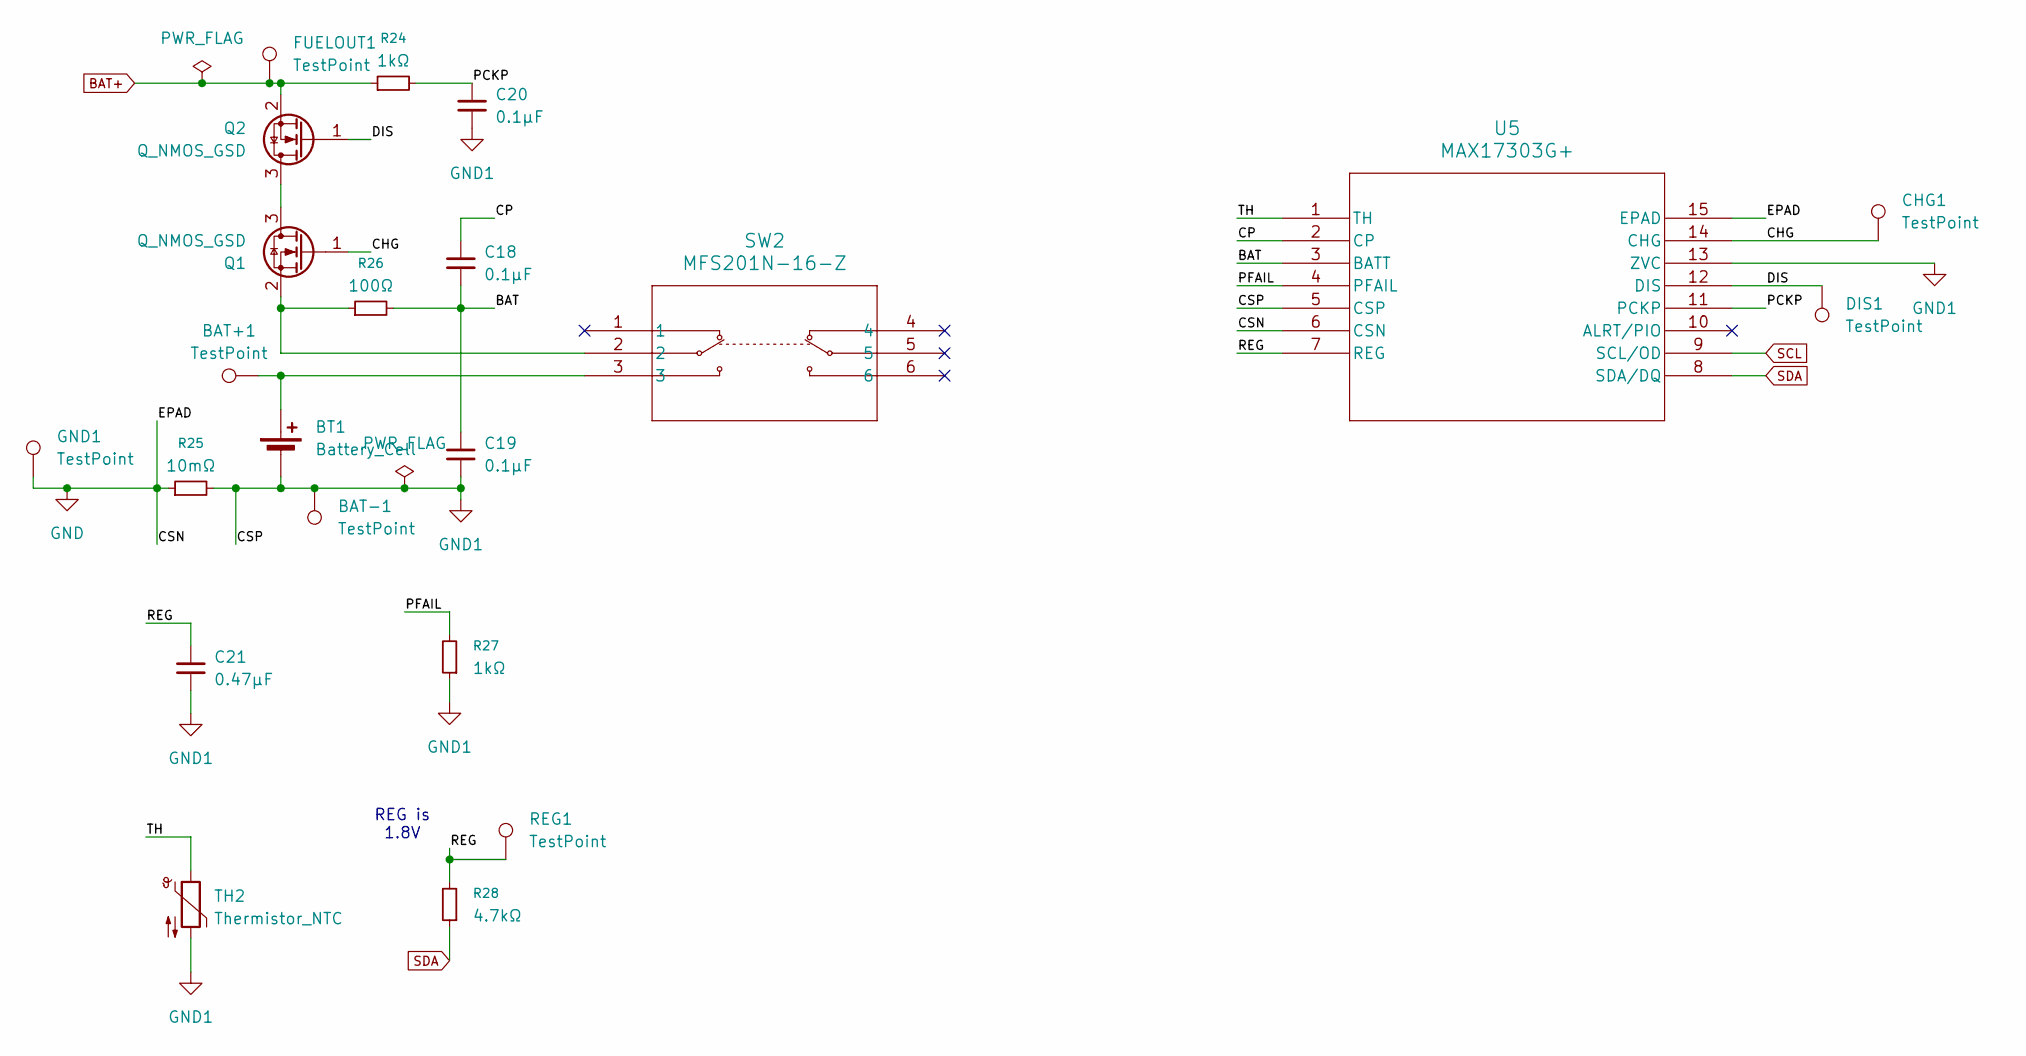
[picture p8: schematic fuel_gauge.kicad_sch]

Parts:
BAT+1: TestPoint; TestPoint_THTPad_D2.0mm_Drill1.0mm
BAT-1: TestPoint; TestPoint_THTPad_D2.0mm_Drill1.0mm
BT1: Battery_Cell; solder_pads
C18, C19, C20: 0.1μF; C_0603_1608Metric
C21: 0.47μF; C_0603_1608Metric
CHG1: TestPoint; TestPoint_THTPad_D2.0mm_Drill1.0mm
DIS1: TestPoint; TestPoint_THTPad_D2.0mm_Drill1.0mm
FUELOUT1: TestPoint; TestPoint_THTPad_D2.0mm_Drill1.0mm
GND1: TestPoint; TestPoint_THTPad_D2.0mm_Drill1.0mm
Q1, Q2: Q_NMOS_GSD; SOT-23
R24, R27: 1kΩ; R_0603_1608Metric
R25: 10mΩ; R_0603_1608Metric
R26: 100Ω; R_0603_1608Metric
R28: 4.7kΩ; R_0603_1608Metric
REG1: TestPoint; TestPoint_THTPad_D2.0mm_Drill1.0mm
SW2: MFS201N-16-Z; MFS201N-16-Z_NDC
TH2: Thermistor_NTC; solder_pads
U5: MAX17303G+; 21-0137I_T1433-2_MXM

Connections:
/BMS/Fuel gauge/BAT: C18.2, C19.1, R26.2, U5.3 (BATT)
/BMS/Fuel gauge/CHG: CHG1.1 (1_1), Q1.1 (G), U5.14 (CHG)
/BMS/Fuel gauge/CP: C18.1, U5.2 (CP)
/BMS/Fuel gauge/DIS: DIS1.1 (1_1), Q2.1 (G), U5.12 (DIS)
/BMS/Fuel gauge/PCKP: C20.1, R24.2, U5.11 (PCKP)
/BMS/Fuel gauge/PFAIL: R27.2, U5.4 (PFAIL)
/BMS/Fuel gauge/REG: C21.1, R28.2, REG1.1 (1_1), U5.7 (REG)
/BMS/Fuel gauge/TH: TH2.1, U5.1 (TH)
BAT+: FUELOUT1.1 (1_1), Q2.2 (S), R24.1; also elsewhere on the board
GND: GND1.1 (1_1), R25.1, U5.6 (CSN), U5.15 (EPAD); also elsewhere on the board
GND1: BAT-1.1 (1_1), BT1.2 (-), C19.2, C20.2, C21.2, R25.2, R27.1, TH2.2, U5.5 (CSP), U5.13 (ZVC)
unnamed: BAT+1.1 (1_1), BT1.1 (+), SW2.3
unnamed: Q1.3 (D), Q2.3 (D)
unnamed: Q1.2 (S), R26.1, SW2.2
SCL: U5.9 (SCL/OD); also elsewhere on the board
SDA: R28.1, U5.8 (SDA/DQ); also elsewhere on the board

Notes on the sheet:
REG is 1.8V

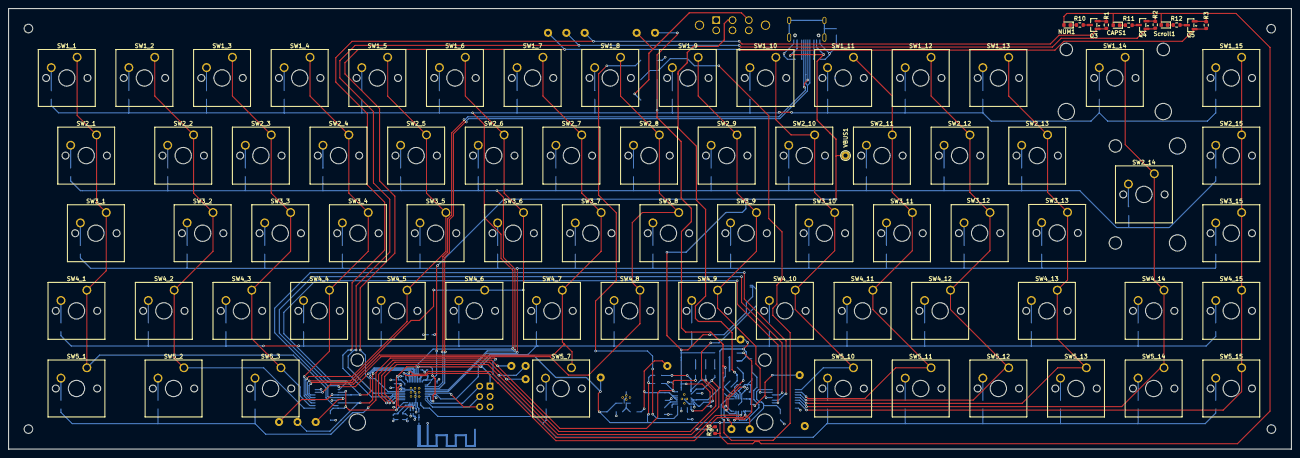
[picture p9: board keyboard.kicad_pcb from above]

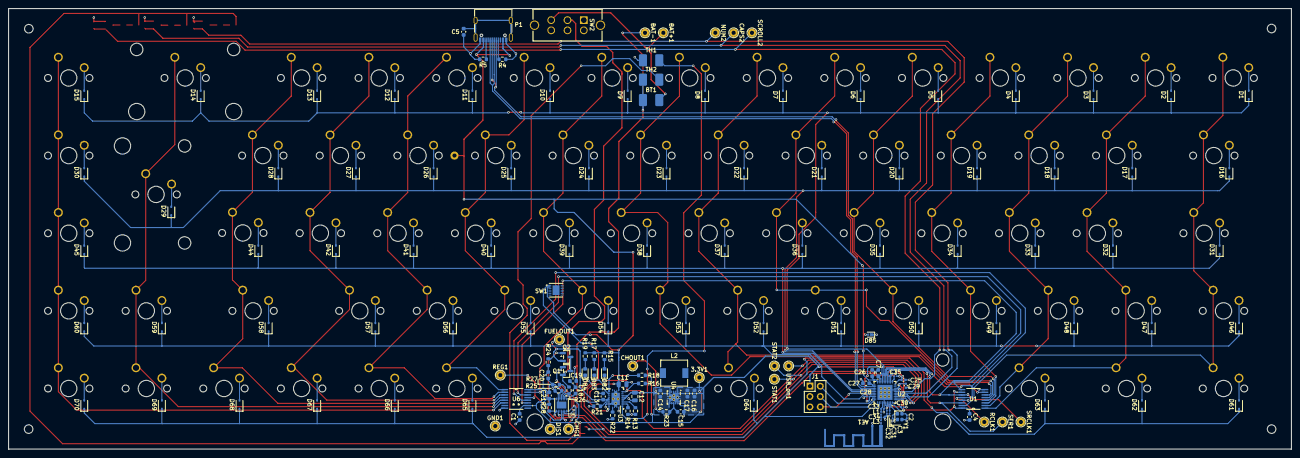
[picture p10: board keyboard.kicad_pcb from below]

Board: 4 copper layers, 314.8 x 108.1 mm, 239 parts (156 on the bottom side), 152 nets.
