Melvin-Larsson/keyboard/(commit log)

2026-10-30 Added more of keyboard
    [bms.kicad_sch, buck_boost.kicad_sch, fuel_gauge.kicad_sch, keyboard.csv, keyboard.kicad_pcb, keyboard.kicad_sch, shift_register.kicad_sch, untitled.kicad_sch]
2026-11-01 stuff and case
    [bms.kicad_sch, buck_boost.kicad_sch, case.FCStd, fuel_gauge.kicad_sch, keyboard.kicad_pcb, keyboard.kicad_sch, model.step, shift_register.kicad_sch]
2026-11-01 Round some edges
    [case.FCStd]
2026-11-01 Change diode footprint
    [keyboard.kicad_pcb, untitled.kicad_sch]
